LeoWPereira/PropellerClock/LaTeX/README.txt

README
------

** Recomendamos o uso do exemplo contido neste diretório para criação do
seu trabalho.
