LeoWPereira/PropellerClock/LaTeX/Propeller Clock.tex

%% Equipe:
%% Leonardo Winter Pereira
%% Geanine Inglat
%% André Eleutério

%% Tema:
%% The Propeller Clock

\documentclass[openright]{normas-utf-tex} %openright = O capítulo começa sempre em páginas ímpares
%\documentclass[oneside]{normas-utf-tex} %oneside = Para dissertações com número de páginas menor que 100 (apenas frente da folha)

\usepackage[alf,abnt-emphasize=bf,bibjustif,recuo=0cm, abnt-etal-cite=2, abnt-etal-list=99]{abntcite} %configuração correta das referências bibliográficas.
\usepackage[brazil, portuges]{babel} % pacote português brasileiro
\usepackage[utf8]{inputenc} % pacote para acentuação direta
\usepackage{amsmath,amsfonts,amssymb} % pacote matemático
\usepackage{graphicx} % pacote gráfico
\usepackage{times} % fonte times
\usepackage{url} % fonte times
\usepackage{listings} % pacote para códigos

%\geometry{left=3.0cm,right=1.5cm,top=4cm,bottom=1cm}       Usado para realizar pequenos ajustes das margens.

% ---------- Preâmbulo ----------
\instituicao{Universidade Tecnológica Federal do Paraná} % nome da instituição
\programa{Curso em Engenharia de Computação} % nome do programa

\documento{Monografia} % [Dissertação] ou [Tese]
\nivel{Graduando} % [Mestrado] ou [Doutorado]
\titulacao{Oficinas de Integração II} % [Mestre] ou [Doutor]

\titulo{\MakeUppercase{Relógio com Varredura Mecânica}} % Título do trabalho em português
\title{\MakeUppercase{The Propeller Clock}} % Título do trabalho em inglês

\autor{Leonardo Winter Pereira, Geanine Inglat, André Eleutério} % Autor do trabalho
\cita{PEREIRA, Leonardo; INGLAT, Geanine; ELEUTÉRIO, André} % sobrenome (maiúsculas), Nome do autor do trabalho

\palavraschave{Relógio com Varredura Mecânica, Arduino, LED} % Palavras-chave do trabalho
\keywords{Propeller Clock, Arduino, LED} % Palavras-chave do trabalho em inglês

\comentario{\UTFPRdocumentodata\ apresentada ao \UTFPRprogramadata\ da \ABNTinstituicaodata\ como requisito parcial para aprovação na disciplina de "\UTFPRtitulacaodata\ ".}

\orientador{César Manuel Vargas Benitez} % nome do orientador do trabalho
\local{Curitiba} % cidade
\data{\the\year} % ano automático

%---------- Inicio do Documento ----------
\begin{document}

\capa % Geração automática da capa
\folhaderosto % Geração automática da folha de rosto

%resumo
%\begin{resumo}

%\end{resumo}

%abstract
%\begin{abstract}

%Abstract text (maximum of 500 words).

%\end{abstract}

% listas (opcionais, mas recomenda-se a partir de 5 elementos)
\listadefiguras % Geração automática da lista de figuras
\listadetabelas % Geração automática da lista de tabelas
\listadesiglas % Geração automática da lista de siglas
\listadesimbolos % Geração automática da lista de símbolos

% sumário
\sumario % Geração automática do sumário

%---------- Início do Texto ----------
\input{Introducao.tex}
\input{Desenvolvimento.tex}
\input{Resultados.tex}
\input{Conclusao.tex}

%---------- Referências ----------
\bibliography{reflatex} % Geração automática das referências a partir do arquivo reflatex.bib

\apendice
%\input{Apendice.tex}

\anexo
\input{Anexos.tex}

\end{document}
