LeoWPereira/PropellerClock/LaTeX/Propeller Clock.pdf

UNIVERSIDADE TECNOLOGICA FEDERAL DO PARAN ´ | Á

### CURSO EM ENGENHARIA DE COMPUTAÇ AÕ

### LEONARDO WINTER PEREIRA, GEANINE INGLAT, ANDRÉ ELEUTERIO ´

RELOGIO COM VARREDURA MEC ´ | ANICA ˆ

### MONOGRAFIA

CURITIBA

2015

### LEONARDO WINTER PEREIRA, GEANINE INGLAT, ANDRÉ ELEUTERIO ´

RELOGIO COM VARREDURA MEC ´ | ANICA ˆ

Monografia apresentada ao Curso em Engenharia de
Computaçao da Universidade Tecnol ˜ | ogica Federal ´
do Parana como requisito parcial para aprovaç ´ | ao na ˜
disciplina de ”Oficinas de Integraçao II ”. ˜

Orientador: Cesar Manuel Vargas Benitez ´

CURITIBA

2015

LISTA DE FIGURAS

–FIGURA 3 | Diagrama Esquematico do Tac ´ | ometro Digital | 15 ˆ
–FIGURA 4 | Distancia razo ˆ | avel para os LED’s | 15 ´
–FIGURA 6 | Proteçao do cooler | 19 ˜
–FIGURA 7 | Esquematico base para a solda | 20 ´

LISTA DE TABELAS

–TABELA 1 | Orçamento para o Display de Varredura Mecanica | | 8 ˆ
–TABELA 2 | Lista de materiais utilizados no Tacometro Digital | | 8 ˆ

LISTA DE SIGLAS

POV | Persistencia da vis ˆ | aõ
LED | Diodo emissor de luz
PCI | Placa de Circuito Impresso

LISTA DE SÍMBOLOS

φ | Phi
β | Beta
µ | micro
Ω | Omega

SUMARIO ´

1 INTRODUÇ AO | | 7 ˜
1.2 CONTEUDOS ENVOLVIDOS | | 9 ´
1.3 METODOLOGIA DE EXECUÇ AO | 10 ˜
2.1 CONSTRUÇ AO DO TAC ˜ | OMETRO DIGITAL | 14 ˆ
2.2 CONSTRUÇ AO DO MOTOR | 17 ˜
2.3 CONSTRUÇ AO DA PCI | 18 ˜

### 3 RESULTADOS E DISCUSSOES | 26 ˜ 4 CONCLUSAO | 28 ˜

REFERENCIAS | 30 ˆ
Anexo A -- CODIGO COMPLETO DO REL ´ | OGIO DE VARREDURA MEC ´ | ANICA | 31 ˆ

### 1 INTRODUÇ AÕ

O propeller clock depende de um fenomeno chamado POV (Persistence of vision, em ˆ

ingles). Persist ˆ | encia da vis ˆ | ao consiste no fen ˜ | omeno observado quando um objeto visto pelo olho ˆ
humano persiste na retina por uma fraçao de segundo ap ˜ | os a sua percepç ´ | ao. Assim, imagens ˜
projetadas com uma frequencia superior a 16Hz associam-se na retina sem interrupç ˆ | ao (WIKI- ˜

PEDIA, 2013) (ANDERSON, 1993).

Segundo essa teoria, ao captar uma imagem, o olho humano levaria uma fraçao de ˜

tempo para ”apaga-la”. Assim, quando os quadros de um filme de cinema s ´ | ao projetados na ˜

tela, o olho mistura o quadro anterior com o seguinte, provocando a ilusao de movimento: um ˜

objeto colocado a esquerda num quadro, aparecendo ` | a direita no quadro seguinte, cria a ilus ` | aõ

de que o objeto se desloca da esquerda para a direita.

Posteriormente foi comprovado que este fenomeno ˆ e mais complexo, e melhor expli- ´

cado quando divido entre Movimento φ e Movimento β, pelo psicologo checo Max Werthei- ´

mer. Porem esta an ´ | alise fisiol ´ | ogica da vis ´ | ao foge do escopo desse trabalho (KAUFMAN, 1974). ˜
A persistencia da vis ˆ | ao pode ser observada no cotidiano ao se ligar um ventilador. ˜
Assim que o ventilador acelera, naõ e poss ´ | ível ver as helices individualmente, somente um ´

círculo.

Isso se aplica ao nosso trabalho pois ao rotacionar rapidamente uma helice com diver- ´

sos LEDs, e ao coordenar o acendimento dos mesmos, e poss ´ ível produzir imagens claramente

visíveis ao olho humano.

1.1 COMPONENTES

A tabela 1 mostra uma relaçao dos materiais necess ˜ | arios para a confecç ´ | ao do display ˜

de varredura mecanica. ˆ

Alem do desenvolvimento do display de varredura mec ´ | anica, foi necess ˆ | ario desenvol- ´
ver um Tacometro digital para Arduino, para ser poss ˆ | ível testar a frequencia do Cooler utilizado ˆ

Produto | Quantidade Valor (Individual)
Arduino Nano | 1 | R$44,00
Latch 74LS373 | 1 | R$1,85
Regulador de tensao 5V - 7805 | 1 | R$1,00 ˜
Capacitor 47 µF | 1 | R$0,75
Cristal 40MHz | 1 | R$0,70
Matriz de Resistores 330Ω | 2 | R$0,08
LED RGB | 16 | R$1,10
Barra de Pinos 28 pinos | 1 | R$0,60
Barra de Pinos 20 pinos | 2 | R$0,60
Diodo emissor IR | 1 | R$0,80
Fototransistor | 1 | R$0,80
Barra de pinos 30 pinos | 1 | R$0,60
Matriz de Contatos de Cobre | 1 | R$8,90
Cooler 3800 RPM | 1 | R$9,10
Slot Bateria 9V | 1 | R$—-
Total | - | R$88.06

Tabela 7: Orçamento para o Display de Varredura Mecanica ˆ

no projeto. Entretanto, este dispositivo sera apenas utilizado como ferramenta de desenvolvi- ´

mento, nao fazendo parte da vers ˜ | ao final do mesmo. ˜

A lista de materiais para este projeto esta listada na tabela 2: ´

Produto | Quantidade Valor (Individual)
Arduino Nano | 1 | R$44,00
Trimpot 5k Ω | 1 | R$0,58
Barra de pinos 30 pinos | 1 | R$0,60
Transistor NPN 2n2222 | 2 | R$0,25
LED IR | 1 | R$0,80
Fototransistor | 1 | R$0,80
Resistor 10Ω | 1 | R$0,08
Resistor 100kΩ | 1 | R$0,08
Resistor 15kΩ | 1 | R$0,08
Protoboard | 1 | R$86,90
Total | - | R$134,42

Tabela 8: Lista de materiais utilizados no Tacometro Digital ˆ

Uma breve descriçao dos principais componentes que constituem o projeto ser ˜ | a reali- ´

zada neste momento:

- Arduino Nano: Sera utilizado para realizar todo o processamento de informaç ´ | | | | oes ne- ˜
cessario no projeto, como por exemplo, o c ´ | alculo do n ´ | umero de rotaç ´ | oes da h ˜ | elice, o ´

controle dos LEDs, entre outros.

- Latch 74LS373: Circuito integrado responsavel por controlar o acendimento dos LEDs. ´
Este componente e necess ´ | ario devido ao baixo n ´ | umero de portas de sa ´ | ída por parte do

Arduino.

- Regulador de tensao 5V – 7805: O regulador de tens ˜ | aõ e necess ´ | ario para poder limitar a ´
tensao nos LEDs, pois a diferença de potencial necess ˜ | aria nestes componentes ´ | e menor ´
do que e necess ´ | ario no cooler. ´
- Capacitor 47 µF: Utilizado como filtro no regulador de tensao. ˜
- Cristal 40MHz: Utilizado para contar o tempo corretamente no relogio. ´
- Matriz de Resistores 330Ω: Utilizada para regular a corrente que vai para os LEDs
- LED RGB: Utilizados para criar o efeito de ilusao de ˜ optica ao acenderem nos momentos ´

certos.

- Socket 28 pinos: Utilizados para poder fixar o Arduino na matriz de contato.
- Diodo emissor IR e Fototransistor: Utilizados para realizar a contagem de rotaçoes por ˜

minuto do cooler.

- Cooler 3800 RPM: Melhor escolha para o motor pois ja possui um circuito pronto de ´
potencia e velocidade. Deve ser de no m ˆ | ínimo 3600 rpm para criar um bom efeito visual.

1.2 CONTEUDOS ENVOLVIDOS ´

Para o desenvolvimento deste projeto, diversos sao os conhecimentos necess ˜ | arios en- ´
volvendo diferentes areas, desde eletr ´ | onica e programaç ˆ | ao at ˜ | e a f ´ | ísica envolvida por tras de ´

alguns aspectos da visao. ˜

Na area de eletr ´ | onica, ˆ | e necess ´ | ario compreender os seguintes aspectos: ´
- Sensores IR: Existem sensores de infravermelho ativos e passivos. Um sensor de infra-

vermelho ativo e composto por um emissor de luz infravermelha e um receptor, que reage ´

a essa luz. Por sua vez, um sensor de infravermelho passivo nao emite luz infravermelha, ˜

mas apenas capta esse tipo de luz no ambiente (ROBOLIVRE, 2014).

Neste projeto, usaremos sensores de infravermelho para medir as rotaçoes do rel ˜ | ogio. ´
- Construçao da PCI: Ser ˜ | a necess ´ | aria a contruç ´ | ao de uma placa de circuito impresso para ˜

o projeto. Nela estarao contidos, entre outros componentes, os LEDs, posicionados da ˜

maneira correta para a visualizaçao otimizada da sa ˜ | ída do projeto. E necess ´ | aria a com- ´
preensao de todos os passos para a criaç ˜ | ao da matriz. ˜
Na area de programaç ´ | ao, ˜ e fundamental compreender como programar o Arduino, pois ´

e ele quem controla o acendimento dos LED’s (ARDUINO, 2014a) (ARDUINO, 2014b). ´

Na area de mec ´ | anica ˆ | e imprescind ´ | ível o calculo exato das rotaç ´ | oes do motor. Erros, ˜

mesmo que pequenos, nesta etapa sao suficientes para que a imagem final seja diferente do ˜

esperado.

Entretanto, a principal preocupaçao ser ˜ | a com conceitos de POV e cad ´ | encia, uma vez ˆ

que abrangem a parte principal do projeto: o objetivo de causar uma ilusao aos olhos do espec- ˜

tador para criar uma imagem (ANDERSON, 1993).

O projeto tambem envolve conhecimento na ´ | area de eletr ´ | onica e programaç ˆ | ao, ˜ | e pre- ´

ciso desenvolver hardware e software que apliquem corretamente os conceitos teoricos estuda- ´

dos. O primeiro projeto similar desenvolvido foi feito em 1995 por Bob Blick e sera utilizado ´

como referencia para o desenvolvimento deste trabalho (BLICK, 2002). ˆ

1.3 METODOLOGIA DE EXECUÇ AÕ

Sera necess ´ | ario construir peças, realizar testes e desenvolver o software do projeto. ´

Construiremos um tacometro, um motor para rotacionar a placa e uma matriz de contatos. A ˆ

construçao do motor depende da construç ˜ | ao do tac ˜ | ometro, enquanto o desenvolvimento do ˆ

software depende de toda a parte de hardware estar pronta pois testes sao fundamentais durante ˜

o processo de desenvolvimento.

A duraçao de cada tarefa varia, com algumas durando apenas um dia e outras mais de ˜

uma semana. A tarefa que mais levara tempo ´ | e a redaç ´ | ao da monografia, pois ser ˜ | a feita com o ´

decorrer do projeto.

O diagrama de blocos, utilizado para demonstrar de forma simples a relaçao entre cada ˜

componente do projeto, esta mostrado na Figura 1. ´

- Construçao do tac ˜ | ometro: Ser ˆ | ao usados um LED infravermelho e um receptor infraver- ˜
melho, alem do cooler onde ser ´ | ao posicionados. Com esse sistema ˜ | e poss ´ | ível contar quan-
tas vezes o sinal e cortado pelas h ´ | elices do cooler, e assim podemos calcular o n ´ | umero de ´
rotaçoes por minuto do sistema. Os c ˜ | alculos ser ´ | ao efetuados com um arduino. ˜
- Construçao da matriz de contatos: S ˜ | ao duas etapas, o design e a construç ˜ | ao. No design ˜


Figura 7: Diagrama de Blocos do projeto

sera desenhado como a placa ser ´ | a impressa e onde ir ´ | ao os componentes. Na construç ˜ | ao, ˜

produziremos a placa com peroxido e depois soldaremos os componentes nela. ´

- Construçao do motor: Para construir o motor, as h ˜ | elices do motor ser ´ | ao removidas e o ˜
motor sera fixado em uma base com uma fonte de alimentaç ´ | ao. ˜
- Integraçao das peças de hardware: Para poder prosseguir com o projeto e finalizar o ˜

hardware, a matriz de contatos, o motor e o Arduino serao integrados. ˜

- Desenvolvimento do software: Sera desenvolvido um algoritmo que coordene o acen- ´
der e apagar dos LEDs para que, ao girarem, formarao uma imagem. O arduino ser ˜ | á

programado. Para programar, usaremos uma interface no computador que nos permite

programar em C e passar esse codigo para o arduino atrav ´ | es da uma porta USB. ´

O diagrama de Gantt do projeto, com as principais tarefas especificadas, esta mostrado ´

na figura 2.

1.4 BANCA EXAMINADORA

- Aluno convidado: Iuri Barcat
- Professor Orientador: Cesar Benitez (DAELN) ´
- Professora convidada: Leyza Dorini (DAINF)
- Professor da disciplina: Hugo Vieira Neto


Figura 8: Diagrama de Gantt do projeto

### 2 METODOLOGIA

Nesta seçao ser ˜ a apresentado o desenvolvimento de todo o projeto, na ordem que o ´

mesmo foi criado. Desta forma fica mais facil para o leitor entender o desenvolvimento do ´

projeto, alem de poder ser utilizado como base para projetos futuros mais facilmente. ´

2.1 CONSTRUÇ AO DO TAC ˜ | OMETRO DIGITAL ˆ
Um tacometro n ˆ | aõ e nada mais que um frequenc ´ | ímetro modificado. Enquanto este
mede a frequencia de uma onda, aquele ˆ | e capaz de medir a frequ ´ | encia de um objeto (desde que ˆ

este objeto realize rotaçoes). ˜

A forma mais facil de se construir tal ferramenta ´ | e utilizando dois LED’s infraver- ´
melhos, um receptor e outro emissor. Inicialmente, a conexao entre os dois est ˜ | a alta (ativa), ´

e quando esta conexao se torna baixa (inativa) significa que algo cortou o sinal entre os dois ˜

LED’s. Desta forma, podemos desenvolver um algoritmo para contar quantas vezes este sinal é

cortado em um minuto, podendo determinar a frequencia do motor utilizado no projeto. ˆ

O diagrama esquematico deste projeto ´ | e simples, e ser ´ | a apresentado na figura 3. ´
Um cuidado especial que teve que ser tomado e a posiç ´ | ao dos LED’s. ˜ | E importante que ´
estes estejam a uma certa distancia um do outro, mas n ˆ | ao muito afastados, e tamb ˜ | em perfeita- ´

mente alinhados, para que o sinal recebido pelo LED receptor seja alto o suficiente para manter

todo o sistema em alto, enquanto o motor nao cort ˜ | a-lo. Uma dist ´ | ancia razo ˆ | avel ´ | e mostrada na ´

figura 4.

Com o hardware feito, foi necessario desenvolver um algoritmo para a contagem da ´

frequencia. Vale lembrar que o pr ˆ | oprio Arduino possui diversas bibliotecas e funç ´ | oes que fa- ˜
cilitaram o desenvolvimento do nosso algoritmo. A funçao attachInterrupt(), por exemplo, ˜ | é

chamada no momento que uma interrupçao no sistema existe (ARDUINO, 2014c). ˜

v o l a t i l e f l o a t tim e = 0 ;

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

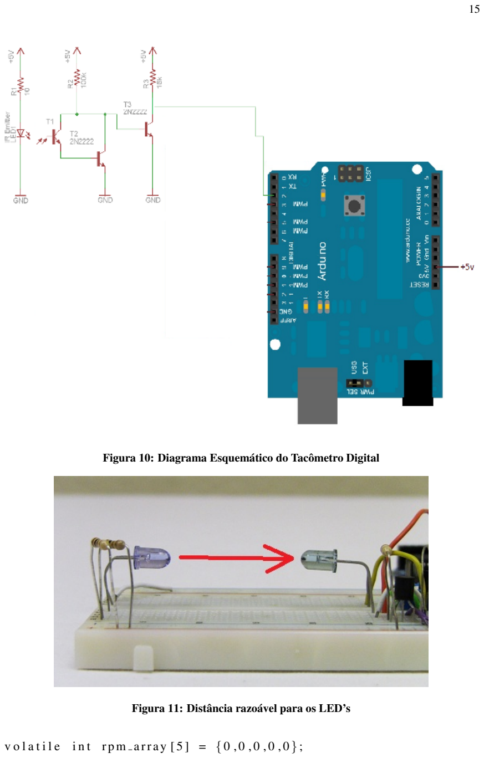
[picture p12: page 16]

Figura 10: Diagrama Esquematico do Tac ´ | ometro Digital ˆ
Figura 11: Distancia razo ˆ | avel para os LED’s ´

v o l a t i l e i n t r p m a r r a y [ 5 ] = { 0 , 0 , 0 , 0 , 0 } ;

v oi d s e t u p ( )
{

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

/ / Mensagem no p r om pt de comando do A r d ui n o

S e r i a l . p r i n t ( ” C u r r e n t RPM: ” ) ;
}

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

/ / e s t e v a l o r na s a i d a S e r i a l

v oi d l o o p ( )
{

i n t rpm = 0 ;

w hil e ( 1 )
{

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

d e l a y ( 4 0 0 ) ;

S e r i a l . p r i n t ( ” | ” ) ;

/ / A t u a l i z a a c o nta gem do RPM

S e r i a l . p r i n t ( rpm ) ;

/ / A t u a l i z a o RPM

i f ( tim e > 0 )
{

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

r p m a r r a y [ 0 ] = r p m a r r a y [ 1 ] ;

r p m a r r a y [ 1 ] = r p m a r r a y [ 2 ] ;

r p m a r r a y [ 2 ] = r p m a r r a y [ 3 ] ;

r p m a r r a y [ 3 ] = r p m a r r a y [ 4 ] ;

/ / 4 e o numero de h e l i c e s do m ot o r

r p m a r r a y [ 4 ] = 6 0 ∗ ( 1 0 0 0 0 0 0/ ( tim e ∗ 4 ) ) ;

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

+ r p m a r r a y [ 3 ] + r p m a r r a y [ 4 ] ) / 5 ;
}
}
}

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

v oi d f a n i n t e r r u p t ( )
{

tim e = ( mi c r o s ( ) − t i m e l a s t ) ;

t i m e l a s t = mi c r o s ( ) ;
}

Com isto, foi possível determinar a velocidade do motor de 2400 rpm ou uma frequencia ˆ

de 40 Hz.

2.2 CONSTRUÇ AO DO MOTOR ˜

Um ponto chave no desenvolvimento do projeto foi encontrar uma soluçao para girar ˜

a PCI com uma velocidade suficiente para gerar o efeito de persistencia da vis ˆ | ao com uma ˜
resoluçao que fosse agrad ˜ | avel aos olhos. Para tal, escolhemos utilizar coolers de gabinete de ´

computador. Em um primeiro momento testamos um cooler pequeno, com alimentaçao de 12 V. ˜

Ele girava a placa (uma protoboard, em uma fase bem primitiva dos testes) com uma velocidade

muito abaixo do esperado. Alem disse foi necess ´ | ario quebrar a parte pl ´ | astica que cobria o cooler ´
para podermos conectar a placa a peça central girat ` | oria. Como a velocidade deste cooler n ´ | aõ

foi suficiente, pesquisamos e compramos um cooler com alimentaçao de 127 230V, da marca ˜

Ultrar. Este cooler e mostrado na figura 5. ´

Utilizamos 127V, e a velocidade de rotaçao atingiu o n ˜ | ível que tínhamos em mente.
Porem, com este cooler mais potente, o problema de conectar a placa na parte girat ´ | oria era mais ´
difícil de ser resolvido pois, ao contrario do cooler de 12V que era revestido por pl ´ | astico, esse ´
cooler e revestido por uma placa de metal maciço. Como esse cooler gira t ´ | ao r ˜ | apido que chega ´


Figura 12: Cooler utilizado no projeto final

a ser perigoso para quem o esta manejando, decidimos manter essa peça de metal e criar uma ´

soluçao para conseguir manter a protoboard fixa ˜ | a peça girat ` | oria. Era necess ´ | ario elevar a placa ´
aproximadamente 15 mm da peça giratoria. Isso se d ´ | a ao fato de que a proteç ´ | aõ e um pouco ´
mais alta que a peça giratoria, e isso causaria atrito entre a placa e a proteç ´ | ao. Esta proteç ˜ | aõ é

mostrada na figura 6.

Em um primeiro momento, foi decidido soldar a bateria que alimenta o Arduino na

propria placa de LEDs e depois criar um contrapeso para que n ´ | ao ficasse inst ˜ | avel. Como a ´

bateria cabe dentro da parte redonda do cooler, ao coloca-la ali conseguimos resolver dois pro- ´

blemas: o do contrapeso da placa e o da elevaçao em relaç ˜ | aõ a proteç ` | ao. Portanto a bateria foi ˜

fixada em cima da parte central do cooler e a placa em cima da bateria.

2.3 CONSTRUÇ AO DA PCI ˜

A parte eletronica do projeto envolvia criar uma placa onde todos os 17 LEDs estives- ˆ

sem conectados ao Arduino e funcionando.


Figura 13: Proteçao do cooler ˜

Primeiramente, e importante mostrar o esquem ´ | atico, utilizado como base para o de- ´
senvolvimento da placa. Este esquematico ´ | e apresentado na figura 7. ´
Em um primeiro momento utilizamos uma protoboard para montar prototipos, por ´ | em´

rapidamente vimos como esta era uma soluçao inadequada devido ao peso e espessura de tal ˜

componente. Entao utilizamos uma matriz de contatos para posicionar os LEDs, resistores e ˜

Arduino. Isso nos dava maior flexibilidade com o posicionamento das peças alem de ser muito ´

leve e ter espessura desprezível.

Como mencionado anteriormente, a bateria foi posicionada diretamente no cooler, por-

tanto nao houve necessidade de nos preocuparmos com contrapeso. J ˜ | a os LEDs foram posici- ´

onados alinhados, com resistores a esquerda e o Arduino abaixo, como apresentado na figura `

8.

A solda final da matriz de contatos ficou como mostrada na figura 9.

Apos a finalizaç ´ | ao da solda, foi verificado que, se a a matriz de contatos fosse real- ˜

mente utilizada, correríamos o risco de algum ponto de solda se soltar, ou ate mesmo ocorrer ´

um curto-circuito no sistema. Desta forma, decidimos descartar a matriz de contatos e desen-

volver uma PCI. Os resultados finais serao vistos nas figuras 10 e 11. ˜

Vale ressaltar que, com o desenvolvimento da PCI, a bateria tambem mudou de lugar, ´

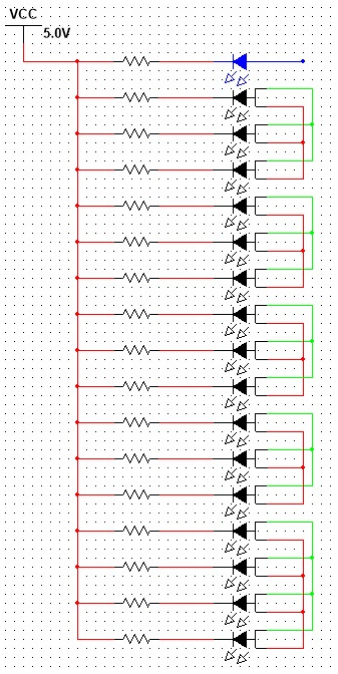
[picture p13: figure]

Figura 14: Esquematico base para a solda ´

para facilitar o carregamento ou ate mesmo uma troca desta, caso haja necessidade. ´

Com a PCI criada, pudemos começar a nos preocupar com o controle dos LED’s por

parte do Arduino, tendo em vista o baixo numero de portas deste e o alto n ´ | umero de LED’s ´
do relogio. Como a velocidade de rotaç ´ | ao varia com a dist ˜ | ancia relativa ao ponto que gira, ˆ

era necessario controlar os LEDs separadamente. Se todos piscassem ao mesmo tempo haveria ´

uma diferença perceptível e os ponteiros do relogio ficariam destorcidos. Para resolver esse ´

problema dividimos os LEDs em 6 grupos. O primeiro LED era controlado individualmente


Figura 15: Estado final da Matriz de Contatos

e ligado apenas a uma porta do Arduino. Este LED ` | e o que gera os pontos fixos que marcam ´

os minutos do relogio. Os outros 16 LEDs foram divididos em 4 grupos de 3 e um de 4 LEDs ´

cada.

Essa proporçao foi escolhida pois era necess ˜ | ario reservar duas porta do Arduino para ´
cada grupo, e esta limitaçao foi o que nos levou a divid ˜ | í-los desta maneira.
Todos os grupos possuem ligaçoes ˜ | a duas portas independentes do Arduino: uma para `

o ponteiro dos minutos e uma para o ponteiro das horas. Isso permite que eles tenham cores

distintas e tambem diferentes da cor do primeiro LED que indica os pontos fixos dos minutos. ´

Portanto o primeiro LED estava conectado a uma porta e cada um dos 5 grupos restan- `

tes estava conectado a duas, utilizando 11 portas no total. `

O ponteiro dos segundos nao fez parte do projeto devido ao n ˜ | umero limitado de portas ´

do Arduino.

A parte mais complicada desta etapa do projeto foi soldar os componentes na PCI (e

na matriz de contatos). Ficou decidido que a propria equipe realizaria a solda (como forma de ´

aprendizado), mesmo sabendo que esta nao ficaria com uma qualidade ˜ | otima. ´

A grande dificuidade desta etapa se deu ao fato de a PCI desenvolvida (e a matriz de


Figura 16: Solda da Matriz de Contatos

contatos tambem, mesmo que esta tenha sido descartada), possui um espaço muito limitado para ´

cada trecho de solda, e tambem por possuirmos equipamentos inapropriados para a execuç ´ | aõ
da mesma (Ferro de Solda de 60W, ao contrario do recomendado, que ´ | e 30W). ´

2.4 SOFTWARE

O objetivo do algoritmo era controlar os grupos de LED de maneira que piscassem

a cada volta, no lugar onde o ponteiro das horas ou minutos correspondentes devesse estar.


Figura 17: PCI vista de cima

Por exemplo, para mostrar 15:30, era necessario que os LEDs piscassem em 270 ´

◦

e 0◦
(tendo

como 0 o lado direito do eixo horizontal que corta o cooler ao meio, como um círculo unitario. ´


Figura 18: PCI vista de baixo

O cooler gira em sentido anti-horario). Ao piscar em 270 ´

- os LEDs mostram o ponteiro dos

minutos em 30min e em 0◦
em 15h.

A ideia do algoritmos foi inspirada em relogios de pulso tradicionais. Ao inv ´ | es de cal- ´
cular o tempo e imprimir os minutos e horas correspondentes, um relogio tradicional ´ | e definido ´

em um determinado horario e simplesmente incrementa os minutos e horas a partir disso. ´

Tendo como medida base de tempo o tempo necessario para uma volta da placa, pu- ´

demos calcular apos quanto tempo depois de passar pelo ponto mais baixo cada LED deveria ´

acender. Isso foi calculado com base no angulo necess ˆ | ario para imprimir cada hora ou minuto. ´
Dividimos o relogio em 60 subdivis ´ | oes de 6 ˜

◦

cada para os minutos e 12 de 30◦ para as horas.

Portanto apos um minuto era necess ´ | ario que o LED piscasse 6 ´

◦
apos o ponto onde ele havia ´ acabado de acender. Como sabemos quanto tempo a placa demora para percorrer 360◦ , podemos calcular quanto ela demora para percorrer 6◦
(Calculamos considerando uma velocidade
constante, o que e apenas uma aproximaç ´ | ao considerando que um objeto com peso distribu ˜ | ído

de forma nao uniforme, sob força da gravidade, rotacionado por um motor comprado em uma ˜

loja de rua nunca girara com velocidade constante. A aproximaç ´ | ao se mostrou v ˜ | alida e n ´ | aõ

afetou os resultados). Ao voltar ao início, a contagem e redefinida. Isso permite que contemos ´

o tempo sem precisar saber qual a hora atual. Apenas começando com a hora correta já e sufici- ´

ente para que o relogio funcione. Essa ideia de incrementar ao inv ´ | es de calcular ´ | e possibilitada ´
por engrenagens em relogio; no nosso caso ´ | e possibilitada por m ´ | etodos delay() e um pouco de ´

física basica. ´

O primeiro LED e o mais simples, pois apenas precisa piscar a cada 6 ´

◦
. Os outros
grupos executam a mesma funçao com os mesmos loops, por ˜ | em com par ´ | ametros de delay dife- ˆ
rentes. Estes diferentes parametros foram definidos com base na frequ ˆ | encia de giro do motor e ˆ

a velocidade de resposta do Arduino.

Todas as portas do Arduino foram definidas como Output e geram 0V de tensao quando ˜

ativadas, assim acendendo o LED, ou 5V, apagando-o.

O codigo foi desenvolvido em Processing, por ´ | em com toda a base em C. Os maio- ´

res desafios encontrados pela equipe foram os tempos de acendimento (por quanto tempo um

LED deve ficar aceso), o tempo de execuçao dos comandos enquanto a placa gira e tamb ˜ | em a ´
coordenaçao dos LEDs. Todo o c ˜ | odigo est ´ | a apresentado no Anexo A. ´

### 3 RESULTADOS E DISCUSSOES ˜

Os resultados obtidos com o desenvolvimento deste trabalho nao realizaram completa- ˜

mente o objetivo proposto neste projeto. As possíveis causas e soluçoes propostas ser ˜ | ao comen- ˜
tadas mais detalhadamente na conclusao deste relat ˜ | orio, por enquanto nos limitaremos a relatar ´

os resultados apresentados e discutir seus significados.

Apos v ´ | arios experimentos com diferentes materiais citados no desenvolvimento chega- ´
mos a um modelo final, utilizando a PCI. Com esta configuraç ` | ao pudemos diminuir as vari ˜ | aveis ´
do projeto, trazendo mais estabilidade, porem, como veremos a seguir, n ´ | ao foi o suficiente. ˜

O modelo final do projeto sera apresentado na figura 12. ´

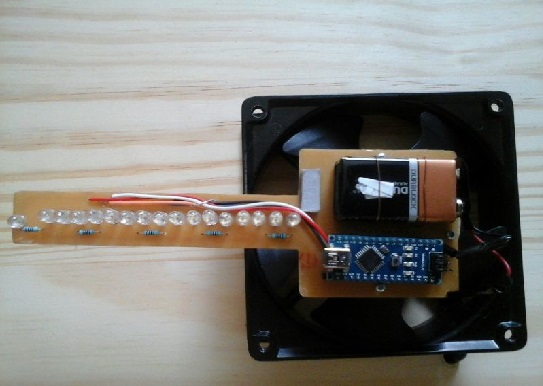
[picture p14: figure]

Figura 20: Modelo final do projeto

Utilizando este modelo, foi possível obter um otimo resultado est ´ | etico no projeto. ´
A placa e o motor, juntos com a bateria para alimentaçao dos componentes eletr ˜ | onicos, en- ˆ

caixaram perfeitamente no hardware desenvolvido pela equipe. Porem, devido ´ | a limitaç ` | oes ˜
físicas, nao foi poss ˜ | ível combinar com sucesso a programaçao do software com o que foi cons- ˜

truído. O algoritmo desenvolvido para o funcionamento do relogio funciona perfeitamente se ´

as limitaçoes do hardware forem desconsideradas, e pode ser usado em novos projetos. ˜

Juntando as duas partes do trabalho (software e hardware) foi possível visualizar os

ponteiros e a borda do relogio, entretanto, os ponteiros n ´ | ao ficaram fixos na posiç ˜ | ao em que ˜
deveriam estar, pois o numero de rotaç ´ | oes por minuto do motor estava variando de acordo com ˜
as condiçoes f ˜ | ísicas do relogio. ´
Realizando varios testes emp ´ | íricos foi possível observar que o software funcionou de
maneira correta e que a variavel que n ´ | ao estava com o comportamento esperado era o n ˜ | umero ´
de rotaçoes por minuto. A base do motor n ˜ | ao estava completamente fixa, causando uma pe- ˜
quena trepidaçao em todo o sistema, a pot ˜ | encia do motor era muito grande para que houvesse ˆ
a estabilidade desejada. Na proxima secç ´ | ao deste trabalho ser ˜ | ao apresentadas as conclus ˜ | oes da ˜

equipe a respeito das soluçoes para o problema. ˜

### 4 CONCLUSAÕ

Os objetivos sugeridos neste projeto nao foram alcançados integralmente. Ap ˜ | os anali- ´
sar os resultados pudemos tirar varias conclus ´ | oes, levantar as causas dos principais problemas e ˜
ate mesmo sugerir soluç ´ | oes para a continuidade deste projeto ou desenvolvimento de trabalhos ˜

similares.

O cronograma proposto foi cumprido em sua maior parte, contudo, quando foi criado

pela equipe, nao previa os problemas mec ˜ | anicos que surgiram ao longo do desenvolvimento ˆ
do projeto. O resultado obtido apresentou limitaçoes na parte f ˜ | ísica que nao permitiram que o ˜

efeito final fosse visualizado de forma correta. Foi possível criar os ponteiros e as bordas do

relogio, por ´ | em, tivemos dificuldades em mant ´ | e-los na posiç ˆ | ao desejada. ˜

Com base no exame dos experimentos empíricos realizados apos o projeto ter sido ´

concluído, foi possível apurar as causas e determinar exatamente onde estava o erro. Percebe-

mos que, devido a alta taxa de rotaç ` | oes por minuto do motor, n ˜ | ao havia estabilidade suficiente ˜
no sistema, conforme a base tremia, o numero de RPM mudava. Mesmo ap ´ | os termos fixado a ´

base da melhor maneira que pudemos, a velocidade das helices ainda variava demasiadamente, ´

impossibilitando o software de funcionar como deveria. Para resolver este problema poderia ser

utilizado um motor com menos potencia, por ˆ | em esta soluç ´ | ao apresentaria um risco ˜ | a imagem `
final exibida nos LED’s, uma vez que existe uma frequencia m ˆ | ínima para que o relogio seja ´
visto perfeitamente a olho nu. Poderia tamb ` | em ter sido adicionado ao projeto um sensor de ´
interrupçao, indicando as rotaç ˜ | oes do motor. Desta forma o algoritmo teria que ser levemente ˜

modificado para que os LED’s piscassem exatamente no momento e na posiçao certa, utilizando ˜

como referencia, al ˆ | em do tempo, os dados retornados pelo sensor. ´

Um resultado positivo que foi apresentado nos testes e o do algoritmo desenvolvido ´

pela equipe. Quando nao existem limitaç ˜ | oes f ˜ | ísicas, o software funciona corretamente. No

futuro, se outros projetos equivalentes forem realizados, este relatorio pode ser utilizado como ´

referencia neste quesito. ˆ

Para continuidade deste projeto seria necessaria a implementaç ´ | ao de um sensor de ˜

interrupçao, semelhante ao tac ˜ | ometro desenvolvido no in ˆ | ício do trabalho. Desta forma, o
numero de rotaç ´ | oes por minuto do motor, juntamente com a h ˜ | elice, seria completamente su- ´
pervisionado pelo Arduino, possibilitando uma maior precisao na posiç ˜ | ao dos LED’s. ˜
Apesar de nao ter sido conclu ˜ | ído completamente, este projeto trouxe resultados satis-
fatorios para toda a equipe, introduzindo novos conte ´ | udos e apresentando desafios que testaram ´

a capacidade dos alunos envolvidos.

REFERENCIAS ˆ

ANDERSON, J. The Myth of Persistence of Vision Revisited. 1993. Disponível em: <http://academic.evergreen.edu/curricular/emergingorder/seminar/week 1 anderson.pdf>. Acesso em: 17 de novembro de 2013.

ARDUINO. | Arduino | Core | functions | and | Libraries. | 2014. | Disponível | em:
<http://en.wikipedia.org/wiki/persistence of vision>. Acesso em: 02 de janeiro de 2014.
ARDUINO. | Arduino | Reference. | 2014. | Disponível | em:
<http://arduino.cc/en/Reference/HomePage>. Acesso em: 02 de janeiro de 2014.
ARDUINO. | Arduino | Reference. | 2014. | Disponível | em:
<http://arduino.cc/en/Reference/attachInterrupt>. Acesso em: 02 de janeiro de 2014.

BLICK, B. ”Propeller Clock”Mechanically Scanned LED Clock. 2002. Disponível em: <http://bobblick.com/techref/projects/propclock/propclock.html>. Acesso em: 17 de novembro de 2013.

KAUFMAN, L. Sight and Mind: An Introduction to Visual Perception. 368: NY: Oxford University Press, 1974.

ROBOLIVRE. | Sensor | de | Infravermelho. | 2014. | Disponível | em:
<http://robolivre.org/conteudo/sensor-de-infravermelho>. Acesso em: | 02 de janeiro de
2014.
WIKIPEDIA. | Persistence | of | Vision. | 2013. | Disponível | em:
<http://en.wikipedia.org/wiki/persistence of vision>. Acesso em: | 17 de novembro de
2013.

ANEXO A -- CODIGO COMPLETO DO REL ´ | OGIO DE VARREDURA MEC ´ | ANICA ˆ

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

∗ de ve s e r chamada com o s g r u p o s 1 , 2 , 3 e 4 com o

∗ s e g u i n t e comando :

∗ bli n kMi n ( g1 a , g2 a , g3 a , g 4 a ) ;
∗ /

v oi d bli n kMi n ( i n t g1 , i n t g2 , i n t g3 , i n t g4 ) {

/ / a c e n d e o s l e d s

d i g i t a l W r i t e ( g4 ,LOW) ;

d i g i t a l W r i t e ( g3 ,LOW) ;

d i g i t a l W r i t e ( g2 ,LOW) ;

d i g i t a l W r i t e ( g1 ,LOW) ;

/ / mantem a c e s o s p el o tempo de pi s c a g em

d e l a y ( p i s c a ) ;

/ / a p a g a o s l e d s

d i g i t a l W r i t e ( g4 , HIGH ) ;

d i g i t a l W r i t e ( g3 , HIGH ) ;

d i g i t a l W r i t e ( g2 , HIGH ) ;

d i g i t a l W r i t e ( g1 , HIGH ) ; }

/ ∗ chamada que a c e n d e o p o n t e i r o da h o r a

∗ de ve s e r chamada com o s g r u p o s 3 e 4 , com o

∗ s e g u i n t e comando :

∗ bli n k H o r a ( g3 v , g 4 v ) ;
∗ /

v oi d bli n k H o r a ( i n t g3 , i n t g4 ) {

/ / a c e n d e o s l e d s

d i g i t a l W r i t e ( g4 ,LOW) ;

d i g i t a l W r i t e ( g3 ,LOW) ;

/ / mantem a c e s o p el o tempo de pi s c a g em

d e l a y ( p i s c a ) ;

/ / a p a g a o s l e d s

d i g i t a l W r i t e ( g4 , HIGH ) ;

d i g i t a l W r i t e ( g3 , HIGH ) ; }

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

v oi d i n c r e m e n t a H o r a r i o ( )
{

/ / i n c r e m e n t a o s mi n ut o s

mi n ut o ++;

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

i f ( mi n ut o == 6 0 )
{

mi n ut o = 0 ;

h o r a ++;

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

i f ( h o r a == 1 2 )

h o r a = 0 ;
}
}

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

∗ cima ) .
∗ /

v oi d c l o c k ( )
{

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

i n t a n g mi n = mi n ut o ∗ 6;

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

i n t a n g h o r a = ( h o r a ∗3 0 ) + ( mi n ut o / 2 ) ;

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

i f ( a n g h o r a < a n g mi n )
{

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

p r o xima ∗ /

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

/ / v a r i a v e l c o n t a d o r a

i n t n = 0 ;

f o r ( n = 0; n<rpm ; n ++ ) {

bli n k H o r a ( g3 v , g 4 v ) ;

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

bli n kMi n ( g1 a , g2 a , g3 a , g 4 a ) ;

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

c l o c k ( ) ;
}

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

e l s e i f ( ang min<a n g h o r a )
{

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

p r o xima ∗ /

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

/ / v a r i a v e l c o n t a d o r a

i n t n = 0 ;

f o r ( n = 0; n<2400; n ++ ) {

bli n kMi n ( g1 a , g2 a , g3 a , g 4 a ) ;

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

bli n k H o r a ( g3 v , g 4 v ) ;

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

/ / a p o s 1min r o d a a f u n c a o mai s uma vez

c l o c k ( ) ;

}

e l s e
{

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

i n t a t r a s o a p o s = 360∗ a r c o mi n ;

/ / l o o p

i n t n = 0 ;

f o r ( n = 0; n<2400; n ++ ) {

bli n k H o r a ( g3 v , g 4 v ) ;

bli n kMi n ( g1 a , g2 a , g3 a , g 4 a ) ;

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

c l o c k ( ) ;
}
}

/ ∗

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

∗ fenomeno da POV .

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

∗ v e rm el h a

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

i n t h o r a = 1 3;

i n t mi n ut o = 5 0;

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

i n t g 4 v = 1 2;

i n t g 4 a = 1 1;

i n t g 3 v = 1 0;

i n t g 3 a = 9 ;

i n t g 2 v = 8 ;

i n t g 2 a = 7 ;

i n t g 1 v = 6 ;

i n t g 1 a = 5 ;

i n t b o r d a = 4 ;

v oi d s e t u p ( )
{

/ / s e t a o s p i n o s como s a i d a s

pinMode ( g4 v , OUTPUT ) ;

pinMode ( g4 a , OUTPUT ) ;

pinMode ( g3 v , OUTPUT ) ;

pinMode ( g3 a , OUTPUT ) ;

pinMode ( g2 v , OUTPUT ) ;

pinMode ( g2 a , OUTPUT ) ;

pinMode ( g1 v , OUTPUT ) ;

pinMode ( g1 a , OUTPUT ) ;

pinMode ( b o r da , OUTPUT ) ;

/ / d e s l i g a o s l e d s

d i g i t a l W r i t e ( g4 v , HIGH ) ;

d i g i t a l W r i t e ( g 4 a , HIGH ) ;

d i g i t a l W r i t e ( g3 v , HIGH ) ;

d i g i t a l W r i t e ( g 3 a , HIGH ) ;

d i g i t a l W r i t e ( g2 v , HIGH ) ;

d i g i t a l W r i t e ( g 2 a , HIGH ) ;

d i g i t a l W r i t e ( g1 v , HIGH ) ;

d i g i t a l W r i t e ( g 1 a , HIGH ) ;

d i g i t a l W r i t e ( b o r da , HIGH ) ; }

v oi d l o o p ( )
{

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

d e l a y ( 5 0 0 0 ) ;

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

d e l a y ( a c c e l ) ;

/ / l o a d i n g ( ) ;

c l o c k ( ) ;
}
